bbl21/STM32_ctrlmodule/docs/项目概况.md

# 射频前端控制模块 — 项目概况

## 1. 项目简介

本系统是 **8~18GHz 射频前端** 的配套控制模块，用于天线选择、极化切换、信号路由、IF 衰减调节和参考通道选择。整个系统由 **STM32F103 控制板（硬件 + 固件）** 和 **Qt6 PC 控制软件（上位机）** 组成，通过 USB CDC（虚拟串口）通信。

### 核心功能

| 功能 | 说明 |
|---|---|
| 天线选择 | 8 路天线 (A-H) 独立选通，每路 V/H 极化可切换 |
| 直通模式 | 天线 B/C/F/G 可选直通（跳过变频级） |
| 下变频控制 | 三组 25中频模块，每通道窄/宽带选择 + 0-15dB 衰减 |
| 参考通道 | 外部 4 路参考信号经 SP4T 4选1 注入第三中频模块 |
| 本振驱动 | 模块 D 为三个 25中频模块提供本振信号 |

---

## 2. 系统架构

### 总体框图

```
                 USB CDC (12字节 = 96位)
PC 控制软件 ───────────────────────────→ STM32F103 固件
(Qt6/C++)      ┌──────────────────┐         │
               │  ControlWord     │         │ reverse_nibble
               │  模板管理         │         │ + 字节重排
               │  手动输入        │         │
               └──────────────────┘         ▼
                                         74HC595 链 (串转并, 96位)
                                             │
                                      ┌──────┴──────┐
                                      │  3× D-sub   │
                                      │  37芯 (5GND  │
                                      │  +32数据/个)  │
                                      └──────┬──────┘
                                             │
                ┌────────────────────────────┼────────────────────┐
                ▼                            ▼                    ▼
        15芯接收变频模块1         15芯接收变频模块2          25中频模块×3
        (天线 A,B,C,D)           (天线 E,F,G,H)          (8天线+1参考)
         K1=A, K2=B,              K1=E, K2=F,           每模块: IF1/IF2/IF3
         K3=C, K4=D               K3=G, K4=H            窄/宽带 + 0-15dB衰减
          B,C有直通(K2ZT/K3ZT)     F,G有直通(K2ZT/K3ZT)
```

### 信号流程

```
══════ RF 射频信号    ─ ─ ─ 本振信号    ······ 参考信号

天线 A (RF) ──┐
天线 B (RF) ──┤  ╔════════════╗
天线 C (RF) ──┤──║ 15芯接收变频 ║── RF ──┐
天线 D (RF) ──┤  ║   模块 1    ║        │
               ╚════════════╝        │
                                        │  ╔════════════╗
天线 E (RF) ──┐  ╔════════════╗       ├──║ C1 25中频   ║── IF1/IF2/IF3
天线 F (RF) ──┤──║ 15芯接收变频 ║── RF ┤  ║ (下变频)    ║    │
天线 G (RF) ──┤  ║   模块 2    ║       │  ╚════════════╝    │
天线 H (RF) ──┘  ╚════════════╝       │  ╔════════════╗    │
                                         │  ║ C2 25中频   ║── │── IF输出
                                         └──║ (下变频)    ║    │   (至后端)
                                            ╚════════════╝    │
                                            ╔════════════╗    │
参考信号 ──── 21芯参考频模II ······ SP4T ──╢ C3 25中频   ║───┘
(外部注入)      (模块B)       4选1         ║ IF1/IF2=天线 ║
                                            ║ IF3=参考通道 ║
                                            ╚════════════╝
                                                ▲     ▲
                                                │     │
                                         ╔══════╧═════╧══╗
                                         ║  模块 D       ║
                                         ║ 功放/本振     ║
                                         ║ (为C提供LO)   ║
                                         ╚═══════════════╝
```

| 步骤 | 路径 | 说明 |
|---|---|---|
| ① 天线接收 | 8 路天线 (A-H) → 15芯接收变频模块 1/2 | 每路 RF 经极化选择 (V/H) 后输出，B/C 和 F/G 可选直通 |
| ② 下变频 | RF → 25中频模块 C1/C2/C3 | 在模块 D 提供的本振信号下，RF 下变频为 IF，同时完成窄/宽带选择和 0-15dB 衰减 |
| ③ 通道分配 | C1→天线 A/B, C2→天线 C/D, C3→天线 E/F + 参考 | 共 9 路 IF 通道（8 天线 + 1 参考），C3 的 IF3 为参考通道输出 |
| ④ 参考注入 | 外部参考信号 → 21芯参考频模II (SP4T 4选1) → C3 IF3 | 模块 B 选择 4 路参考之一，送入 C3 的第 3 路 IF |
| ⑤ 本振供给 | 模块 D → C1/C2/C3 | 模块 D 为三个 25中频模块提供本振信号驱动下变频 |

---

## 3. 硬件设计

### 控制板 (STM32F103)

主控芯片 **STM32F103C8T6**，通过 SPI 驱动 12 片 74HC595 移位寄存器链，产生 96 位并行控制信号，经三路 D-sub 37 芯连接器输出至各射频模块。

#### 引脚分配

| 引脚 | 功能 | 连接 |
|---|---|---|
| PA5 | SPI1 SCK | 74HC595 SHCP (移位时钟) |
| PA7 | SPI1 MOSI | 74HC595 DS (串行数据) |
| PB3 | 输出使能 | 74HC595 OE (低有效) |
| PB5 | 锁存信号 | 74HC595 STCP (上升沿锁存) |
| PA11/USB_DM | USB 差分负 | USB CDC |
| PA12/USB_DP | USB 差分正 | USB CDC |

#### 74HC595 链结构

- 12 片 74HC595 级联，每片 8 位 → 96 位并行输出
- 每路 D-sub 37 芯连接器分配 32 位数据 + 5 位 GND
- 上电默认 OE 为高（输出高阻），初始化后拉低使能

### 子模块清单

| 模块 | 数量 | 接插件 | 控制信号 |
|---|---|---|---|
| 15芯接收变频模块 | 2 | 15芯 J30J | K1A/B-K4A/B (V/H), K2ZT, K3ZT |
| 21芯参考频模II | 1 | 21芯 J30J | KCKA, KCKB (SP4T) |
| 25中频模块 | 3 | 25芯 J30J | 窄/宽带 + 1/2/3ATT1/2/4/8 |
| 9芯功放模块 | 1 | 9芯 J30J | 仅供电 |

#### 天线分配

| 模块 | 天线 | 直通 |
|---|---|---|
| 15芯模块1 | A (K1), B (K2), C (K3), D (K4) | B, C |
| 15芯模块2 | E (K1), F (K2), G (K3), H (K4) | F, G |

---

## 4. 固件设计 (STM32F103)

### 目录: `firmware/`

| 文件 | 功能 |
|---|---|
| `Core/Src/main.c` | 主循环：轮询 `data_received`，执行 96 位全位序反转，SPI 发送，PB5 锁存 |
| `USB_DEVICE/App/usbd_cdc_if.c` | CDC 接收回调 `CDC_Receive_FS()`，接收 12 字节后置标志 |
| `Core/Src/stm32f1xx_hal_msp.c` | SPI1 引脚初始化 (PA5=SCK, PA7=MOSI) |
| `Core/Src/stm32f1xx_it.c` | USB 中断处理 |

### 核心算法

从 USB CDC 接收 12 字节后，固件执行 96 位全位序反转，将 PC 端定义的位位置映射到 74HC595 链的并行输出顺序：

```c
// 12字节(96位) → 96位全位序反转 → 6×16位 SPI (MSB first)
for (int i = 0; i < 12; i++) {
    for (int b = 0; b < 8; b++) {
        if (received_data[i] & (0x80 >> b)) {
            int pos = 95 - (i * 8 + b);
            spi_buffer[pos / 16] |= (0x8000 >> (pos % 16));
        }
    }
}
// SPI 发送 6×16 位，PB5 脉冲锁存
```

**特性：PC 输入的第 n 位 = 595 输出的第 n 位**，全位序反转补偿了 SPI MSB-first 传输与 595 级联间的位序差异。

### 工作流程

```
上电 → 初始化(HAL/SPI/USB) → PB3=0 使能输出 → 主循环:
  ┌─ CDC 收到 12 字节?
  ├─ 是 → 回显 Received: + 12字节hex
  │     → 96位全位序反转 → SPI 发送 → PB5 脉冲锁存
  │     → 回显 SPI Send: + 6×16位hex
  │     → 回显 Operation completed
  └─ 否 → 继续轮询
```

> **调试回显**：固件通过 CDC 回传接收/发送数据用于调试，PC 端可在日志窗口查看。

---

## 5. PC 控制软件 (Qt6/C++)

### 目录: `software/pc_control/`

| 文件 | 功能 |
|---|---|
| `main.cpp` | Qt 应用入口 |
| `mainwindow.h/cpp` | 主窗口、布局、工具栏、手动输入 |
| `controlword.h/cpp` | 96 位控制字构建核心类 |
| `cdccomm.h/cpp` | CDC 串口通信 |
| `templatemanager.h/cpp` | 模板 JSON 保存/加载 |
| `themedata.h/cpp` | 明暗双主题引擎 + QSS 生成器 |
| `antennastatuspanel.h/cpp` | 九宫格天线面板（V/名/H/直通） |
| `attenuatorpanel.h/cpp` | 9通道 IF 衰减 + 宽窄带 + 参考通道 |
| `statspanel.h/cpp` | 状态监视（Hex/二进制/日志） |
| `app.rc` / `app.ico` | 应用图标资源 |

### 构建

```bash
cd software/pc_control
cmake -B build -DCMAKE_PREFIX_PATH=/path/to/Qt6-static
cmake --build build --config Release
```

产物: `build/rf_frontend_control.exe` — **静态链接 Qt 6.8.3**（13.5 MB，零外部 DLL 依赖）

### 编译

运行: `build/rf_frontend_control.exe` (单 exe，无 DLL 依赖)

### 软件特性

- **明暗双主题**：暗色 (`#0a0a0a`) / 亮色 (`#f2f2f2`)，工具栏一键切换，主题偏好持久化
- **九宫格天线面板**：每天线独立 V/H 极化、直通开关，状态实时回显
- **模板管理**：将当前全状态保存为模板（JSON，含脏掩码），支持应用/修改/删除/双击应用；内置 STANDBY 模板
- **手动输入**：直接填写 12 字节十六进制控制字
- **衰减控制**：9 路独立 0-15dB 滑条 + 窄/宽带联动
- **参考通道**：SP4T 四选一控制字生成
- **实时通信日志**：发送/接收数据帧记录
- **数据目录**：`%APPDATA%/rf_frontend_control/`

---

## 6. 通信协议

### USB CDC (虚拟串口)

| 参数 | 值 |
|---|---|
| 接口 | USB 2.0 Full-Speed (12 Mbps) |
| CDC 类 | 抽象控制模型 (ACM) |
| 数据帧 | 12 字节固定帧，96 位控制字 |
| 方向 | 双向：PC→固件（控制字下发），固件→PC（调试回显） |
| 回显协议 | 固件收到 12 字节后，依次回传 "Received: XX..."、"SPI Send: XXXX..."、"Operation completed" |
| 波特率 | 虚拟串口忽略，USB 原生速率 |

### 数据帧

```
位 0-95: 96 位控制字
字节 0-11: 大端序，每字节低位在先 (因 nibble swap 补偿)
```

### 固件处理

```
USB 12 字节 → 96位全位序反转 → 6 × 16 位 SPI → 595 锁存
```

---

## 7. 96 位控制字映射

### 硬件数据路径

```
PC CDC (12字节=96位) → STM32F103 SPI1 (6×16位, MSB first)
  → 74HC595 移位寄存器链 (串转并, 96位并行输出)
  → 3× D-sub 37芯接插件 (每个: 5×GND + 32×数据线)
  → 子模块 J30J 接插件
```

### D-sub 37 芯接插件

每个 D-sub 37 芯：引脚 1-5 = GND，引脚 6-37 = 32 位数据线。

### 位映射详表

#### D-sub 1 (位 0-31) — 15芯接收变频模块 ×2 + 参考通道

| 位 | D-sub 引脚 | 信号 | 归属 | 说明 |
|----|---|---|---|---|
| **15芯接收变频模块 1 (天线 A,B,C,D) — 天线2(B)天线3(C)有直通** |
| 0 | pin6  | K3B | 天线 C V | 1=通 |
| 1 | pin7  | K3A | 天线 C H | 1=通 |
| 2 | pin8  | K4B | 天线 D V | 1=通 |
| 3 | pin9  | K4A | 天线 D H | 1=通 |
| 4 | pin10 | K1A | 天线 A V | 1=通 |
| 5 | pin11 | K1B | 天线 A H | 1=通 |
| 6 | pin12 | K2A | 天线 B V | 1=通 |
| 7 | pin13 | K2B | 天线 B H | 1=通 |
| 8 | pin14 | K2ZT | 天线 B 直通 | 1=直通 0=截止 |
| 9 | pin15 | K3ZT | 天线 C 直通 | 1=直通 0=截止 |
| **15芯接收变频模块 2 (天线 E,F,G,H) — 天线2(F)天线3(G)有直通** |
| 10 | pin16 | K3B | 天线 G V | 1=通 |
| 11 | pin17 | K3A | 天线 G H | 1=通 |
| 12 | pin18 | K4B | 天线 H V | 1=通 |
| 13 | pin19 | K4A | 天线 H H | 1=通 |
| 14 | pin20 | K1A | 天线 E V | 1=通 |
| 15 | pin21 | K1B | 天线 E H | 1=通 |
| 16 | pin22 | K2A | 天线 F V | 1=通 |
| 17 | pin23 | K2B | 天线 F H | 1=通 |
| 18 | pin24 | K2ZT | 天线 F 直通 | 1=直通 0=截止 |
| 19 | pin25 | K3ZT | 天线 G 直通 | 1=直通 0=截止 |
| **参考通道 SP4T** |
| 20 | pin26 | KCKA | 参考通道选择 A | 见编码表 |
| 21 | pin27 | KCKB | 参考通道选择 B | 见编码表 |
| **备用** |
| 22-31 | pin28-37 | — | — | 保留 |

#### D-sub 2 (位 32-63) — 25中频模块 C1 + C2

C1 占 18 位连续，C2 占 14 位，C2 的 IF3 衰减（位 64-67）在 D-sub3 开头。

| 位 | D-sub 引脚 | 信号 | 归属 | 说明 |
|----|---|---|---|---|
| **C1: 25中频模块 1 (位32-49, 18位)** |
| 32 | pin6  | KIF11 | IF1 窄带入 | 联动对 |
| 33 | pin7  | KIF12 | IF1 窄带出 | 联动对 |
| 34 | pin8  | KIF21 | IF2 窄带入 | 联动对 |
| 35 | pin9  | KIF22 | IF2 窄带出 | 联动对 |
| 36 | pin10 | KIF31 | IF3 窄带入 | 联动对 |
| 37 | pin11 | KIF32 | IF3 窄带出 | 联动对 |
| 38 | pin12 | 1ATT1 | IF1 衰减1dB | ⬅ |
| 39 | pin13 | 1ATT2 | IF1 衰减2dB | |
| 40 | pin14 | 1ATT4 | IF1 衰减4dB | |
| 41 | pin15 | 1ATT8 | IF1 衰减8dB | ➡ |
| 42 | pin16 | 2ATT1 | IF2 衰减1dB | ⬅ |
| 43 | pin17 | 2ATT2 | IF2 衰减2dB | |
| 44 | pin18 | 2ATT4 | IF2 衰减4dB | |
| 45 | pin19 | 2ATT8 | IF2 衰减8dB | ➡ |
| 46 | pin20 | 3ATT1 | IF3 衰减1dB | ⬅ |
| 47 | pin21 | 3ATT2 | IF3 衰减2dB | |
| 48 | pin22 | 3ATT4 | IF3 衰减4dB | |
| 49 | pin23 | 3ATT8 | IF3 衰减8dB | ➡ |
| **C2: 25中频模块 2 (位50-63, 14位；IF3衰减→D-sub3位64-67)** |
| 50 | pin24 | KIF11 | IF1 窄带入 | 联动对 |
| 51 | pin25 | KIF12 | IF1 窄带出 | 联动对 |
| 52 | pin26 | KIF21 | IF2 窄带入 | 联动对 |
| 53 | pin27 | KIF22 | IF2 窄带出 | 联动对 |
| 54 | pin28 | KIF31 | IF3 窄带入 | 联动对 |
| 55 | pin29 | KIF32 | IF3 窄带出 | 联动对 |
| 56 | pin30 | 1ATT1 | IF1 衰减1dB | ⬅ |
| 57 | pin31 | 1ATT2 | IF1 衰减2dB | |
| 58 | pin32 | 1ATT4 | IF1 衰减4dB | |
| 59 | pin33 | 1ATT8 | IF1 衰减8dB | ➡ |
| 60 | pin34 | 2ATT1 | IF2 衰减1dB | ⬅ |
| 61 | pin35 | 2ATT2 | IF2 衰减2dB | |
| 62 | pin36 | 2ATT4 | IF2 衰减4dB | |
| 63 | pin37 | 2ATT8 | IF2 衰减8dB | ➡ |

#### D-sub 3 (位 64-95) — C2 续 + C3 + 备用

| 位 | D-sub 引脚 | 信号 | 归属 | 说明 |
|----|---|---|---|---|
| **C2 续 (位64-67, 接D-sub2位50-63后)** |
| 64 | pin6  | 3ATT1 | C2 IF3 衰减1dB | ⬅ |
| 65 | pin7  | 3ATT2 | C2 IF3 衰减2dB | |
| 66 | pin8  | 3ATT4 | C2 IF3 衰减4dB | |
| 67 | pin9  | 3ATT8 | C2 IF3 衰减8dB | ➡ |
| **C3: 25中频模块 3 (位68-85, 18位)** |
| 68 | pin10 | KIF11 | IF1 窄带入 | 联动对 |
| 69 | pin11 | KIF12 | IF1 窄带出 | 联动对 |
| 70 | pin12 | KIF21 | IF2 窄带入 | 联动对 |
| 71 | pin13 | KIF22 | IF2 窄带出 | 联动对 |
| 72 | pin14 | KIF31 | IF3 窄带入 | 联动对 |
| 73 | pin15 | KIF32 | IF3 窄带出 | 联动对 |
| 74 | pin16 | 1ATT1 | IF1 衰减1dB | ⬅ |
| 75 | pin17 | 1ATT2 | IF1 衰减2dB | |
| 76 | pin18 | 1ATT4 | IF1 衰减4dB | |
| 77 | pin19 | 1ATT8 | IF1 衰减8dB | ➡ |
| 78 | pin20 | 2ATT1 | IF2 衰减1dB | ⬅ |
| 79 | pin21 | 2ATT2 | IF2 衰减2dB | |
| 80 | pin22 | 2ATT4 | IF2 衰减4dB | |
| 81 | pin23 | 2ATT8 | IF2 衰减8dB | ➡ |
| 82 | pin24 | 3ATT1 | IF3 衰减1dB | ⬅ |
| 83 | pin25 | 3ATT2 | IF3 衰减2dB | |
| 84 | pin26 | 3ATT4 | IF3 衰减4dB | |
| 85 | pin27 | 3ATT8 | IF3 衰减8dB | ➡ |
| **备用** |
| 86-95 | pin28-37 | — | — | 保留 |

### 参考通道编码 (KCKA, KCKB)

| KCKA | KCKB | 参考通道 |
|---|---|---|
| 1 | 1 | 通道 1 |
| 1 | 0 | 通道 2 |
| 0 | 1 | 通道 3 |
| 0 | 0 | 通道 4 |

### IF 宽窄带联动

KIFx1 (入) 和 KIFx2 (出) 应联动控制：

| KIFx1 (入) | KIFx2 (出) | 模式 |
|---|---|---|
| 0 (窄带)  | 1 (窄带) | 窄带 |
| 1 (宽带)  | 0 (宽带) | 宽带 |

### IF 衰减组合

| ATT1 | ATT2 | ATT4 | ATT8 | 总衰减 |
|---|---|---|---|---|
| 0 | 0 | 0 | 0 | 0dB |
| 1 | 0 | 0 | 0 | 1dB |
| 0 | 1 | 0 | 0 | 2dB |
| 1 | 1 | 0 | 0 | 3dB |
| 0 | 0 | 1 | 0 | 4dB |
| 0 | 0 | 0 | 1 | 8dB |
| 1 | 1 | 1 | 1 | 15dB |

---

## 8. 硬件接口与连线

### 控制板 → 射频模块

```
控制板 (STM32F103)
  │
  ├── D-sub 1 (37芯) ──── 15芯接收变频模块1 (天线 A-D)
  │                          ├── K1A/B: 天线 A V/H
  │                          ├── K2A/B: 天线 B V/H
  │                          ├── K2ZT:  天线 B 直通
  │                          ├── K3A/B: 天线 C V/H
  │                          ├── K3ZT:  天线 C 直通
  │                          └── K4A/B: 天线 D V/H
  │
  ├── D-sub 2 (37芯) ──── 15芯接收变频模块2 (天线 E-H)
  │                      + 25中频模块1 (C1) + 25中频模块2 (C2)
  │
  └── D-sub 3 (37芯) ──── 25中频模块3 (C3) + 参考通道
```

### USB 连接

```
PC ── USB A ── USB 线 ── USB Mini-B ── 控制板 (STM32F103)
```

## 8. 硬件接口与连线

### 控制板 → 射频模块

```
控制板 (STM32F103)
  │
  ├── D-sub 1 (37芯) ──── 15芯接收变频模块1 (天线 A-D)
  │                          ├── K1A/B: 天线 A V/H
  │                          ├── K2A/B: 天线 B V/H
  │                          ├── K2ZT:  天线 B 直通
  │                          ├── K3A/B: 天线 C V/H
  │                          ├── K3ZT:  天线 C 直通
  │                          └── K4A/B: 天线 D V/H
  │
  ├── D-sub 2 (37芯) ──── 15芯接收变频模块2 (天线 E-H)
  │                      + 25中频模块1 (C1) + 25中频模块2 (C2)
  │
  └── D-sub 3 (37芯) ──── 25中频模块3 (C3) + 参考通道
```

### USB 连接

```
PC ── USB A ── USB 线 ── USB Mini-B ── 控制板 (STM32F103)
```

---

## 9. 文件索引

```
STM32_ctrlmodule/
├── firmware/                     (STM32F103 固件)
│   ├── Core/Src/main.c           主循环 + SPI + 位序反转
│   ├── Core/Src/stm32f1xx_hal_msp.c  SPI 引脚初始化 (PA5=SCK, PA7=MOSI)
│   ├── Core/Src/stm32f1xx_it.c    USB 中断
│   ├── USB_DEVICE/App/usbd_cdc_if.c  CDC 接收 + 调试回显
│   └── ctrl_module_v4.ioc         CubeMX 配置
│
├── software/                     (PC 上位机)
│   └── pc_control/                Qt6 C++ 控制软件
│       ├── src/                   源码
│       └── CMakeLists.txt         构建配置
│
├── hardware/                     (电路设计)
│   ├── lceda/                     立创EDA 工程文件
│   ├── bom/                       BOM 物料清单
│   └── pnp/                       Pick & Place
│
├── enclosure/                    (外壳 3D 模型)
│   ├── 上盖.STEP.SLDPRT
│   └── 底盒.STEP.SLDPRT
│
├── docs/                         (项目文档)
│   ├── 项目概况.md                 本文档
│   ├── 96位数据位映射定义.md         位映射详表
│   └── ...                        其他资料
│
└── .gitignore
```

---

## 10. 开发环境

| 组件 | 版本 | 位置 |
|---|---|---|
| MCU | STM32F103C8T6, STM32CubeIDE | — |
| PC 编译 | MSVC 14.44 + CMake 3.31 | VS2022 BuildTools |
| Qt (动态) | 6.8.3 msvc2022_64 | `~/Qt/6.8.3/msvc2022_64` |
| Qt (静态, 单 exe) | 6.8.3 自编译 -static | `~/Qt/6.8.3-static/msvc2022_64` |
| PCB 设计 | 立创EDA | — |
| 3D 建模 | SolidWorks 2022 | — |
