bbl21/STM32_ctrlmodule/firmware/docs/96位数据位映射定义.md

# 96 位数据位映射定义

## 硬件架构

```
PC CDC (12字节=96位)
  → STM32F103 SPI1 (6×16位, MSB first)
  → 74HC595 移位寄存器链 (串转并, 96位并行输出)
  → 3× D-sub 37芯接插件 (每个: 5×GND + 32×数据线)
  → 子模块 J30J 接插件
```

### D-sub 37 芯接插件引脚定义

每个 D-sub 37 芯：
| 引脚范围 | 功能 |
|---|---|
| 1-5 | GND (共地) |
| 6-37 | 32 位数据线 |

---

## CDC → SPI 映射算法 (核心)

### 黑箱行为

**PC 输入 96 位 → MCU 处理后 → 595 输出 96 位 = 一一对应。**

具体地说，PC 发过来的 96 位数据中第 N 位（从 0 开始计数），经过 MCU 处理后，最终落到物理连线上第 N 个输出位（D-sub 各接插件引脚6-37 顺序排列）。

关键在于算法补偿了 CDC 字节序和 SPI 硬件时序之间的差异，使 PC 视角无需关心底层细节。

### 逐级映射详解

#### 第 1 层：PC 字节 → received_data[]

PC 发送 12 个字节（96 位），按 USB CDC 流顺序存入 `received_data[0..11]`。

```
PC 发送字节顺序:  byte0  byte1  byte2  ...  byte11
                         ↓
MCU 接收数组:  received_data[0..11]
```

#### 第 2 层：received_data[] → nibble 交换 + 组内逆序

每 4 字节为一组（共 3 组），组内执行：

```
原始字节: [b0] [b1] [b2] [b3]
                ↓  reverse_nibble()
nibble 交换: [rn(b0)] [rn(b1)] [rn(b2)] [rn(b3)]
                ↓  组内逆序组合
SPI 字:  spi_buffer[2i]   = rn(b3):rn(b2)   (高16位)
          spi_buffer[2i+1] = rn(b1):rn(b0)   (低16位)
```

`reverse_nibble()` 函数：

```c
// 输入:  0x1K  (高4位=1, 低4位=K)
// 输出:  0xK1  (高4位=K, 低4位=1)
static uint8_t reverse_nibble(uint8_t byte) {
    return ((byte & 0x0F) << 4) | ((byte & 0xF0) >> 4);
}
```

#### 第 3 层：spi_buffer[] → SPI 发送 (MSB first)

依次发送 6 个 16 位字，每个字 MSB first（先发高位，后发低位）。

```
SPI 线上 bit 流顺序:
buf[0].b15 → ... → buf[0].b0 → buf[1].b15 → ... → buf[1].b0
→ buf[2].b15 → ... → buf[5].b15 → ... → buf[5].b0
```

#### 第 4 层：SPI 位流 → 595 链 → 并行输出

74HC595 是串入并出移位寄存器，链式级联。**最先移入的 bit 到达链尾（最远一级 595），最后移入的 bit 停在链头（最近一级 595）。**

```
SPI 位流顺序 (时间先后)
  先发送 ───── buf[0].b15 → ... → buf[5].b0 ───── 后发送
               ↓                          ↓
          最远一级 595  ← ... ←  最近一级 595
          (D-sub3.pin37)          (D-sub1.pin6)

物理输出对应:
  D-sub1.pin6   ← LSB(buf[5])  ← 最近 595 的第 0 位
  D-sub1.pin7   ← bit1(buf[5]) ← 最近 595 的第 1 位
  ...
  D-sub3.pin37  ← MSB(buf[0])  ← 最远 595 的第 15 位
```

### 验证：PC 输入 "1000" → 输出 "0001"

以 4 位为例演示 nibble 补偿：

```
PC 发送 1 字节:  0x80  (二进制 1000 0000)
      高4位=1000, 低4位=0000

reverse_nibble(0x80):
  高4位 ← 原低4位 = 0000
  低4位 ← 原高4位 = 1000
  → 0x08  (二进制 0000 1000)

nibble "1000" 从高4位 → 低4位 = 0001 ← 输出映射
```

物理结果：PC 送的高 nibble "1000" 经由 nibble 交换后变为低 nibble，落在 D-sub 对应引脚上。从 PC 视角看，"1000" 输入对应的是同一个物理引脚上的 "1"，完成了 1:1 映射。

### 完整对应表

**96 位数据 → D-sub 引脚对照（按物理输出位置，从近到远）：**

| 输出位序 | 数据位标号 | D-sub 引脚 | 来源 |
|---|---|---|---|
| 0 | bit[0] | D-sub1.pin6  | `received_data[8]` nibble 交换后的 bit0 |
| 1 | bit[1] | D-sub1.pin7  | `received_data[8]` nibble 交换后的 bit1 |
| ... | ... | ... | ... |
| 31 | bit[31] | D-sub1.pin37 | `received_data[11]` nibble 交换后的 bit7 |
| 32 | bit[32] | D-sub2.pin6  | `received_data[4]` nibble 交换后的 bit0 |
| ... | ... | ... | ... |
| 63 | bit[63] | D-sub2.pin37 | `received_data[7]` nibble 交换后的 bit7 |
| 64 | bit[64] | D-sub3.pin6  | `received_data[0]` nibble 交换后的 bit0 |
| ... | ... | ... | ... |
| 95 | bit[95] | D-sub3.pin37 | `received_data[3]` nibble 交换后的 bit7 |

> 注：transmit 后拉高 PB5 (STCP) 产生上升沿锁存，将移位寄存器内容并行输出到 595 输出引脚。

---

## D-sub 1 (位 0-31) → 子模块映射

**对应 SPI 字:** `spi_buffer[0..1]`

### 连接子模块

1. **参考频模** (15 芯 J30J) — 10 路 LVTTL
2. **参考频模 II** (21 芯 J30J) — 2 路 LVTTL (KCKA, KCKB)
3. 备用/未分配位

### 位分配表

| 位编号 | D-sub 引脚 | 子模块 | J30J 信号 | 说明 | 逻辑 |
|---|---|---|---|---|---|
| **参考频模 (10 位)** |
| 0  | D-sub1.pin6  | 参考频模 | K3B | 开关 3B 控制 | 1=通, 0=断 |
| 1  | D-sub1.pin7  | 参考频模 | K3A | 开关 3A 控制 | 1=通, 0=断 |
| 2  | D-sub1.pin8  | 参考频模 | K4B | 开关 4B 控制 | 1=通, 0=断 |
| 3  | D-sub1.pin9  | 参考频模 | K4A | 开关 4A 控制 | 1=通, 0=断 |
| 4  | D-sub1.pin10 | 参考频模 | K1A | 开关 1A 控制 | 1=通, 0=断 |
| 5  | D-sub1.pin11 | 参考频模 | K1B | 开关 1B 控制 | 1=通, 0=断 |
| 6  | D-sub1.pin12 | 参考频模 | K2A | 开关 2A 控制 | 1=通, 0=断 |
| 7  | D-sub1.pin13 | 参考频模 | K2B | 开关 2B 控制 | 1=通, 0=断 |
| 8  | D-sub1.pin14 | 参考频模 | K2ZT  | 通道 2 直通选择 | 1=直通, 0=截止 |
| 9  | D-sub1.pin15 | 参考频模 | K3ZT  | 通道 3 直通选择 | 1=直通, 0=截止 |
| **参考频模 II (2 位)** |
| 10 | D-sub1.pin16 | 参考频模II | KCKA  | 参考通道选择 A | 见表 |
| 11 | D-sub1.pin17 | 参考频模II | KCKB  | 参考通道选择 B | 见表 |
| **备用地线 (5 路)** |
| —  | D-sub1.pin1-5 | 参考频模 | GND×5 | 模块共地 (每个 D-sub 固定 5 针) |
| **备用位 (20 位)** |
| 12-31 | D-sub1.pin18-37 | — | — | 保留/未分配 | — |

### KCKA, KCKB 编码表

| KCKA | KCKB | 参考通道 |
|---|---|---|
| 1 | 1 | 通道 1 |
| 1 | 0 | 通道 2 |
| 0 | 1 | 通道 3 |
| 0 | 0 | 通道 4 |

---

## D-sub 2 (位 32-63) → 子模块映射

**对应 SPI 字:** `spi_buffer[2..3]`

### 连接子模块

1. **第一路 25 频模** (25 芯 J30J) — IF1/IF2/IF3 控制 (18 路 LVTTL)
2. 备用 14 位

### 位分配表

| 位编号 | D-sub 引脚 | 子模块 | J30J 信号 | 说明 | 逻辑 |
|---|---|---|---|---|---|
| **IF 窄带/宽带选择 (6 位)** |
| 32 | D-sub2.pin6  | 25频模-IF1 | KIF11 | IF1 窄带开关(入) | 0=窄带, 1=宽带 |
| 33 | D-sub2.pin7  | 25频模-IF2 | KIF21 | IF2 窄带开关(入) | 0=窄带, 1=宽带 |
| 34 | D-sub2.pin8  | 25频模-IF3 | KIF31 | IF3 窄带开关(入) | 0=窄带, 1=宽带 |
| 35 | D-sub2.pin9  | 25频模-IF3 | KIF32 | IF3 窄带开关(出) | 1=窄带, 0=宽带 |
| 36 | D-sub2.pin10 | 25频模-IF2 | KIF22 | IF2 窄带开关(出) | 1=窄带, 0=宽带 |
| 37 | D-sub2.pin11 | 25频模-IF1 | KIF12 | IF1 窄带开关(出) | 1=窄带, 0=宽带 |
| **IF3 衰减器 (4 位)** |
| 38 | D-sub2.pin12 | 25频模-IF3 | 3ATT1 | IF3 衰减 1dB | 1=衰减 |
| 39 | D-sub2.pin13 | 25频模-IF3 | 3ATT2 | IF3 衰减 2dB | 1=衰减 |
| 40 | D-sub2.pin14 | 25频模-IF3 | 3ATT4 | IF3 衰减 4dB | 1=衰减 |
| 41 | D-sub2.pin15 | 25频模-IF3 | 3ATT8 | IF3 衰减 8dB | 1=衰减 |
| **IF2 衰减器 (4 位)** |
| 42 | D-sub2.pin16 | 25频模-IF2 | 2ATT1 | IF2 衰减 1dB | 1=衰减 |
| 43 | D-sub2.pin17 | 25频模-IF2 | 2ATT2 | IF2 衰减 2dB | 1=衰减 |
| 44 | D-sub2.pin18 | 25频模-IF2 | 2ATT4 | IF2 衰减 4dB | 1=衰减 |
| 45 | D-sub2.pin19 | 25频模-IF2 | 2ATT8 | IF2 衰减 8dB | 1=衰减 |
| **IF1 衰减器 (4 位)** |
| 46 | D-sub2.pin20 | 25频模-IF1 | 1ATT1 | IF1 衰减 1dB | 1=衰减 |
| 47 | D-sub2.pin21 | 25频模-IF1 | 1ATT2 | IF1 衰减 2dB | 1=衰减 |
| 48 | D-sub2.pin22 | 25频模-IF1 | 1ATT4 | IF1 衰减 4dB | 1=衰减 |
| 49 | D-sub2.pin23 | 25频模-IF1 | 1ATT8 | IF1 衰减 8dB | 1=衰减 |
| **备用地线 (5 路)** |
| —  | D-sub2.pin1-5 | 25频模 | GND×5 | 模块共地 | — |
| **备用位 (14 位)** |
| 50-63 | D-sub2.pin24-37 | — | — | 保留/未分配 | — |

### IF 衰减组合

| ATT1 | ATT2 | ATT4 | ATT8 | 总衰减 |
|---|---|---|---|---|
| 0 | 0 | 0 | 0 | 0dB |
| 1 | 0 | 0 | 0 | 1dB |
| 0 | 1 | 0 | 0 | 2dB |
| 1 | 1 | 0 | 0 | 3dB |
| 0 | 0 | 1 | 0 | 4dB |
| 0 | 0 | 0 | 1 | 8dB |
| 1 | 1 | 1 | 1 | 15dB (最大) |

---

## D-sub 3 (位 64-95) → 子模块映射

**对应 SPI 字:** `spi_buffer[4..5]`

### 连接子模块

1. **第二路 25 频模** (25 芯 J30J) — 第二路 IF1/IF2/IF3 控制 (18 路)
2. 或 **第三路 25 频模** (18 路)
3. **9 芯功放模块** (无控制信号，仅供电)
4. 备用位

### 位分配表 (方案: 第二路 25 频模)

| 位编号 | D-sub 引脚 | 子模块 | J30J 信号 | 说明 | 逻辑 |
|---|---|---|---|---|---|
| **IF 窄带/宽带选择 (6 位)** |
| 64 | D-sub3.pin6  | 25频模-路2-IF1 | KIF11 | IF1 窄带开关(入) | 0=窄带, 1=宽带 |
| 65 | D-sub3.pin7  | 25频模-路2-IF2 | KIF21 | IF2 窄带开关(入) | 0=窄带, 1=宽带 |
| 66 | D-sub3.pin8  | 25频模-路2-IF3 | KIF31 | IF3 窄带开关(入) | 0=窄带, 1=宽带 |
| 67 | D-sub3.pin9  | 25频模-路2-IF3 | KIF32 | IF3 窄带开关(出) | 1=窄带, 0=宽带 |
| 68 | D-sub3.pin10 | 25频模-路2-IF2 | KIF22 | IF2 窄带开关(出) | 1=窄带, 0=宽带 |
| 69 | D-sub3.pin11 | 25频模-路2-IF1 | KIF12 | IF1 窄带开关(出) | 1=窄带, 0=宽带 |
| **IF3 衰减器 (4 位)** |
| 70 | D-sub3.pin12 | 25频模-路2-IF3 | 3ATT1 | IF3 衰减 1dB | 1=衰减 |
| 71 | D-sub3.pin13 | 25频模-路2-IF3 | 3ATT2 | IF3 衰减 2dB | 1=衰减 |
| 72 | D-sub3.pin14 | 25频模-路2-IF3 | 3ATT4 | IF3 衰减 4dB | 1=衰减 |
| 73 | D-sub3.pin15 | 25频模-路2-IF3 | 3ATT8 | IF3 衰减 8dB | 1=衰减 |
| **IF2 衰减器 (4 位)** |
| 74 | D-sub3.pin16 | 25频模-路2-IF2 | 2ATT1 | IF2 衰减 1dB | 1=衰减 |
| 75 | D-sub3.pin17 | 25频模-路2-IF2 | 2ATT2 | IF2 衰减 2dB | 1=衰减 |
| 76 | D-sub3.pin18 | 25频模-路2-IF2 | 2ATT4 | IF2 衰减 4dB | 1=衰减 |
| 77 | D-sub3.pin19 | 25频模-路2-IF2 | 2ATT8 | IF2 衰减 8dB | 1=衰减 |
| **IF1 衰减器 (4 位)** |
| 78 | D-sub3.pin20 | 25频模-路2-IF1 | 1ATT1 | IF1 衰减 1dB | 1=衰减 |
| 79 | D-sub3.pin21 | 25频模-路2-IF1 | 1ATT2 | IF1 衰减 2dB | 1=衰减 |
| 80 | D-sub3.pin22 | 25频模-路2-IF1 | 1ATT4 | IF1 衰减 4dB | 1=衰减 |
| 81 | D-sub3.pin23 | 25频模-路2-IF1 | 1ATT8 | IF1 衰减 8dB | 1=衰减 |
| **备用地线 (5 路)** |
| —  | D-sub3.pin1-5 | 25频模路2 / 功放 | GND×5 | 模块共地 | — |
| **备用位 (14 位)** |
| 82-95 | D-sub3.pin24-37 | — | — | 保留/未分配 | — |

> 注：如果只有第一路 25 频模，则 D-sub 3 的 18 位 (位 64-81) 可作为备用或扩展给其他模块。

---

## 汇总：96 位地址空间总表

| 位范围 | 位计数 | D-sub | 子模块 | 功能 |
|---|---|---|---|---|
| 0-9 | 10 | 1 | 参考频模 | 开关 K1A-K4B, K2ZT, K3ZT |
| 10-11  | 2 | 1 | 参考频模II | 参考通道选择 KCKA, KCKB |
| 12-31  | 20 | 1 | — | 备用 (D-sub1 未用数据线) |
| 32-37  | 6 | 2 | 25频模-第一路 | IF1/2/3 窄带选择 |
| 38-41  | 4 | 2 | 25频模-IF3 | 3ATT1/2/4/8 衰减 |
| 42-45  | 4 | 2 | 25频模-IF2 | 2ATT1/2/4/8 衰减 |
| 46-49  | 4 | 2 | 25频模-IF1 | 1ATT1/2/4/8 衰减 |
| 50-63  | 14 | 2 | — | 备用 (D-sub2 未用数据线) |
| 64-69  | 6 | 3 | 25频模-第二路 | IF1/2/3 窄带选择 (若存在) |
| 70-73  | 4 | 3 | 25频模-第二路-IF3 | 3ATT1/2/4/8 (若存在) |
| 74-77  | 4 | 3 | 25频模-第二路-IF2 | 2ATT1/2/4/8 (若存在) |
| 78-81  | 4 | 3 | 25频模-第二路-IF1 | 1ATT1/2/4/8 (若存在) |
| 82-95  | 14 | 3 | — | 备用 (D-sub3 未用数据线) |

---

## GND 分配

每个 D-sub 37 芯接插件固定提供 5 根 GND 线（引脚 1-5）到子模块侧。

子模块 GND 需求：

| 子模块 | J30J 自带 GND | 需从 D-sub 获取 | 说明 |
|---|---|---|---|
| 参考频模 15芯 J30J | 引脚 5,6,13 (3路) | D-sub1 至少 1 路 | 其余走模块内部共地 |
| 参考频模II 21芯 J30J | 引脚 4-8,15,18 (7路) | D-sub1 至少 1 路 | 模块内 GND 充足 |
| 25频模 25芯 J30J | 引脚 4-9 (6路) | D-sub2/3 至少 1 路 | 每路 25 频模需独立 GND |
| 9芯功放 9芯 J30J | 引脚 4,5,8,9 (4路) | D-sub3 至少 1 路 | 纯供电模块 |

D-sub 接插件上所有 GND 引脚 (1-5) 在控制模块内部共地。

---

## STM32 代码对应关系

| 代码位置 | 内容 |
|---|---|
| `main.c:48` | `uint16_t spi_buffer[6]` — 6 个 16 位 SPI 数据 |
| `main.c:50-51` | `extern uint8_t received_data[12]`, `extern uint8_t data_received` |
| `main.c:61-68` | `reverse_byte()` — 全位反转 (旧版算法用) |
| `main.c:71-73` | `reverse_nibble()` — 高低四位交换 (当前算法) |
| `main.c:154-163` | 12 字节 → nibble swap → 重组 6×16 位 SPI 数据 |
| `main.c:175` | `HAL_SPI_Transmit()` — 发送 6 个 16 位数据到 595 链 |
| `main.c:176-178` | PB5 脉冲上升沿锁存并行输出 |
| `main.c:124-127` | PB3=低(使能595输出), PB5=低(STCP初始) |
| `usbd_cdc_if.c:262-277` | `CDC_Receive_FS()` — 接收 12 字节 USB CDC 数据 |
