bbl21/STM32_ctrlmodule/docs/96位数据位映射定义.md

# 96 位数据位映射定义

## 硬件架构

```
PC CDC (12字节=96位)
  → STM32F103 SPI1 (6×16位, MSB first)
  → 74HC595 移位寄存器链 (串转并, 96位并行输出)
  → 3× D-sub 37芯接插件 (每个: 5×GND + 32×数据线)
  → 子模块 J30J 接插件
```

### D-sub 37 芯接插件引脚定义

每个 D-sub 37 芯：
| 引脚范围 | 功能 |
|---|---|
| 1-5 | GND (共地) |
| 6-37 | 32 位数据线 |

---

## 总线模块清单

| 模块 | 数量 | 控制信号 | 说明 |
|---|---|---|---|
| 15芯接收变频模块 | 2个 | 10路/个 | 每个控制4个天线，KxA=V极 KxB=H极 |
| 25中频模块 | 3个 | 15路/个(+3备用) | 对应8天线+1参考通道 |
| 参考通道开关 | 1个 | 2路 | SP4T (KCKA, KCKB) 四选一 |

### 模块-天线对应

**15芯接收变频模块 1** — 天线 A, B, C, D
| J30J 信号 | 位置 | 控制对象 | 直通 |
|---|---|---|---|
| K1A/K1B | 天线1 | 天线 A V/H | 无 |
| K2A/K2B | 天线2 | 天线 B V/H | K2ZT |
| K3A/K3B | 天线3 | 天线 C V/H | K3ZT |
| K4A/K4B | 天线4 | 天线 D V/H | 无 |

**15芯接收变频模块 2** — 天线 E, F, G, H
| J30J 信号 | 位置 | 控制对象 | 直通 |
|---|---|---|---|
| K1A/K1B | 天线1 | 天线 E V/H | 无 |
| K2A/K2B | 天线2 | 天线 F V/H | K2ZT |
| K3A/K3B | 天线3 | 天线 G V/H | K3ZT |
| K4A/K4B | 天线4 | 天线 H V/H | 无 |

**25 中频模块 ×3** — 每模块对应一组 IF1/IF2/IF3 通道
| J30J 信号 | 数量 | 说明 |
|---|---|---|
| KIF1x (11/12) | 1路联动 | IF1 宽窄带选择，11入12出联动 |
| KIF2x (21/22) | 1路联动 | IF2 宽窄带选择 |
| KIF3x (31/32) | 1路联动 | IF3 宽窄带选择 |
| iATT1/2/4 (i=1,2,3) | 9路 | IF1/2/3 衰减器 0-7dB |
| iATT8 (备用) | 3路 | IF1/2/3 衰减器扩展 8dB |

**参考通道**
| SP4T 信号 | 编码 | 说明 |
|---|---|---|
| KCKA, KCKB | 11/10/01/00 | 参考通道 1/2/3/4 四选一 |

---

## 96 位地址分配

### D-sub 1 (位 0-31) — 15芯接收变频模块 ×2 + 参考通道

| 位 | D-sub 引脚 | 信号 | 归属 | 说明 |
|----|---|---|---|---|
| **15芯接收变频模块 1 (天线 A,B,C,D) — 天线2(B)天线3(C)有直通** |
| 0 | pin6  | K3B | 天线 C V | 1=通 |
| 1 | pin7  | K3A | 天线 C H | 1=通 |
| 2 | pin8  | K4B | 天线 D V | 1=通 |
| 3 | pin9  | K4A | 天线 D H | 1=通 |
| 4 | pin10 | K1A | 天线 A V | 1=通 |
| 5 | pin11 | K1B | 天线 A H | 1=通 |
| 6 | pin12 | K2A | 天线 B V | 1=通 |
| 7 | pin13 | K2B | 天线 B H | 1=通 |
| 8 | pin14 | K2ZT | 天线 B 直通 | 1=直通 0=截止 |
| 9 | pin15 | K3ZT | 天线 C 直通 | 1=直通 0=截止 |
| **15芯接收变频模块 2 (天线 E,F,G,H) — 天线2(F)天线3(G)有直通** |
| 10 | pin16 | K3B | 天线 G V | 1=通 |
| 11 | pin17 | K3A | 天线 G H | 1=通 |
| 12 | pin18 | K4B | 天线 H V | 1=通 |
| 13 | pin19 | K4A | 天线 H H | 1=通 |
| 14 | pin20 | K1A | 天线 E V | 1=通 |
| 15 | pin21 | K1B | 天线 E H | 1=通 |
| 16 | pin22 | K2A | 天线 F V | 1=通 |
| 17 | pin23 | K2B | 天线 F H | 1=通 |
| 18 | pin24 | K2ZT | 天线 F 直通 | 1=直通 0=截止 |
| 19 | pin25 | K3ZT | 天线 G 直通 | 1=直通 0=截止 |
| **参考通道 SP4T** |
| 20 | pin26 | KCKA | 参考通道选择 A | 见编码表 |
| 21 | pin27 | KCKB | 参考通道选择 B | 见编码表 |
| **备用** |
| 22-31 | pin28-37 | — | — | 保留 |

### D-sub 2 (位 32-63) — 25中频模块 C1 + C2（C2 续 D-sub3）

C1 占 18 位连续，C2 占 14 位，末 4 位（IF3 衰减）在 D-sub3 开头。

| 位 | D-sub 引脚 | 信号 | 归属 | 说明 |
|----|---|---|---|---|
| **C1: 25中频模块 1 (位32-49, 18位)** |
| 32 | pin6  | KIF11 | IF1 窄带入 | 联动对 |
| 33 | pin7  | KIF12 | IF1 窄带出 | 联动对 |
| 34 | pin8  | KIF21 | IF2 窄带入 | 联动对 |
| 35 | pin9  | KIF22 | IF2 窄带出 | 联动对 |
| 36 | pin10 | KIF31 | IF3 窄带入 | 联动对 |
| 37 | pin11 | KIF32 | IF3 窄带出 | 联动对 |
| 38 | pin12 | 1ATT1 | IF1 衰减1dB | ⬅ IF1 衰减连续4位 |
| 39 | pin13 | 1ATT2 | IF1 衰减2dB | |
| 40 | pin14 | 1ATT4 | IF1 衰减4dB | |
| 41 | pin15 | 1ATT8 | IF1 衰减8dB | ➡ |
| 42 | pin16 | 2ATT1 | IF2 衰减1dB | |
| 43 | pin17 | 2ATT2 | IF2 衰减2dB | |
| 44 | pin18 | 2ATT4 | IF2 衰减4dB | |
| 45 | pin19 | 2ATT8 | IF2 衰减8dB | |
| 46 | pin20 | 3ATT1 | IF3 衰减1dB | |
| 47 | pin21 | 3ATT2 | IF3 衰减2dB | |
| 48 | pin22 | 3ATT4 | IF3 衰减4dB | |
| 49 | pin23 | 3ATT8 | IF3 衰减8dB | |
| **C2: 25中频模块 2 (位50-63, 14位；IF3衰减→D-sub3位64-67)** |
| 50 | pin24 | KIF11 | IF1 窄带入 | 联动对 |
| 51 | pin25 | KIF12 | IF1 窄带出 | 联动对 |
| 52 | pin26 | KIF21 | IF2 窄带入 | 联动对 |
| 53 | pin27 | KIF22 | IF2 窄带出 | 联动对 |
| 54 | pin28 | KIF31 | IF3 窄带入 | 联动对 |
| 55 | pin29 | KIF32 | IF3 窄带出 | 联动对 |
| 56 | pin30 | 1ATT1 | IF1 衰减1dB | ⬅ IF1 衰减连续4位 |
| 57 | pin31 | 1ATT2 | IF1 衰减2dB | |
| 58 | pin32 | 1ATT4 | IF1 衰减4dB | |
| 59 | pin33 | 1ATT8 | IF1 衰减8dB | ➡ |
| 60 | pin34 | 2ATT1 | IF2 衰减1dB | |
| 61 | pin35 | 2ATT2 | IF2 衰减2dB | |
| 62 | pin36 | 2ATT4 | IF2 衰减4dB | |
| 63 | pin37 | 2ATT8 | IF2 衰减8dB | |

### D-sub 3 (位 64-95) — C2 续 + C3 + 备用

| 位 | D-sub 引脚 | 信号 | 归属 | 说明 |
|----|---|---|---|---|
| **C2 续 (位64-67, 接D-sub2位50-63后)** |
| 64 | pin6  | 3ATT1 | C2 IF3 衰减1dB | D-sub2位50-63的后续 |
| 65 | pin7  | 3ATT2 | C2 IF3 衰减2dB | |
| 66 | pin8  | 3ATT4 | C2 IF3 衰减4dB | |
| 67 | pin9  | 3ATT8 | C2 IF3 衰减8dB | |
| **C3: 25中频模块 3 (位68-85, 18位)** |
| 68 | pin10 | KIF11 | IF1 窄带入 | 联动对 |
| 69 | pin11 | KIF12 | IF1 窄带出 | 联动对 |
| 70 | pin12 | KIF21 | IF2 窄带入 | 联动对 |
| 71 | pin13 | KIF22 | IF2 窄带出 | 联动对 |
| 72 | pin14 | KIF31 | IF3 窄带入 | 联动对 |
| 73 | pin15 | KIF32 | IF3 窄带出 | 联动对 |
| 74 | pin16 | 1ATT1 | IF1 衰减1dB | ⬅ IF1 衰减连续4位 |
| 75 | pin17 | 1ATT2 | IF1 衰减2dB | |
| 76 | pin18 | 1ATT4 | IF1 衰减4dB | |
| 77 | pin19 | 1ATT8 | IF1 衰减8dB | ➡ |
| 78 | pin20 | 2ATT1 | IF2 衰减1dB | |
| 79 | pin21 | 2ATT2 | IF2 衰减2dB | |
| 80 | pin22 | 2ATT4 | IF2 衰减4dB | |
| 81 | pin23 | 2ATT8 | IF2 衰减8dB | |
| 82 | pin24 | 3ATT1 | IF3 衰减1dB | |
| 83 | pin25 | 3ATT2 | IF3 衰减2dB | |
| 84 | pin26 | 3ATT4 | IF3 衰减4dB | |
| 85 | pin27 | 3ATT8 | IF3 衰减8dB | |
| **备用** |
| 86-95 | pin28-37 | — | — | 保留 |

---

## KCKA, KCKB 编码

| KCKA | KCKB | 参考通道 |
|---|---|---|
| 1 | 1 | 通道 1 |
| 1 | 0 | 通道 2 |
| 0 | 1 | 通道 3 |
| 0 | 0 | 通道 4 |

---

## IF 宽窄带联动

KIFx1 和 KIFx2 应联动控制：

| KIFx1 (入) | KIFx2 (出) | 模式 |
|---|---|---|
| 0 (窄带)  | 1 (窄带) | 窄带 |
| 1 (宽带)  | 0 (宽带) | 宽带 |

## IF 衰减组合

| ATT1 | ATT2 | ATT4 | ATT8 | 总衰减 |
|---|---|---|---|---|
| 0 | 0 | 0 | 0 | 0dB |
| 1 | 0 | 0 | 0 | 1dB |
| 0 | 1 | 0 | 0 | 2dB |
| 1 | 1 | 0 | 0 | 3dB |
| 0 | 0 | 1 | 0 | 4dB |
| 0 | 0 | 0 | 1 | 8dB |
| 1 | 1 | 1 | 1 | 15dB |
