bbl21/STM32_ctrlmodule/hardware/bom/BOM_11542416A_Y1.xls

客户BOM清单 |  |  |  |  |  | 嘉立创用料信息
Comment | Description | Designator | Footprint | LibRef | Quantity | 匹配类型 | 匹配方式 | 匹配来源 | 顶层位号 | 顶层数 | 顶层贴装 | 底层位号 | 底层数 | 底层贴装 | 元件编号 | X-ray检查 | 贴装总数量 | 焊点总数量 | 焊点费小计 | 库类型 | 组装方式 | 元件名称 | 原厂型号 | 封装规格 | 最小起订数量 | 损耗数量 | 元器件来源 | 使用预订数量 | 工厂提供数量 | 工厂元件单价 | 工厂元件小计 | 换料费 | 收费原因
Type-C | USB-Type-C_16P | USB1 | TYPE-C_16P | USB-Type-C | 1 | 手动调整 | 手动替换 |  | USB1 | 1 | 已贴装 |  | 0 | 未贴装 | C165948 | 不需要 | 2 | 32 | 0.3200 | 扩展库 | 贴装 | Type-C 母 卧贴 | TYPE-C-31-M-12 | SMD | 2 | 0 | 商城现货 | 0 | 2 | 1.1290 | 2.2580 | 20.00
104 |  | C16,C17,C18,C19,C20,C21,C22,C23,C24,C25,C26,C27 | 0603 | 0603电容 | 12 | 系统识别 | 自动匹配 |  | C16, C17, C18, C19, C20, C21, C22, C23, C24, C25, C26, C27 | 12 | 已贴装 |  | 0 | 未贴装 | C14663 | 不需要 | 32 | 64 | 0.6400 | 基础库 | 贴装 | 100nF ±10% 50V | CC0603KRX7R9BB104 | 0603 | 0 | 0 | 商城现货 | 0 | 32 | 0.0156 | 0.4992 | 0.00
104，X7R |  | C1,C2,C3,C4 | 0603 | 0603电容 | 4 | 系统识别 | 自动匹配 |  | C1, C2, C3, C4 | 4 | 已贴装 |  | 0 | 未贴装 | C14663 | 不需要
330 |  | R7,R8 | 0603 | 0603电阻 | 2 | 手动调整 | 手动替换 |  | R7, R8 | 2 | 已贴装 |  | 0 | 未贴装 | C23140 | 不需要 | 4 | 8 | 0.0800 | 基础库 | 贴装 | 33Ω ±1% 100mW 厚膜电阻 | 0603WAF330JT5E | 0603 | 0 | 0 | 商城现货 | 0 | 4 | 0.0071 | 0.0284 | 0.00
LP5951MF-3.3 |  | U1,U2 | SOT23-5_2r90x1r60-H1r18-P0r95_G | LP5951MF-3.3 | 2 | 手动调整 | 手动替换 |  | U1, U2 | 2 | 已贴装 |  | 0 | 未贴装 | C80670 | 不需要 | 4 | 20 | 0.2000 | 扩展库 | 贴装 | 具有低 IQ 和使能功能的 250mA、低噪声、高 PSRR、超低压降稳压器 | LP5907MFX-3.3/NOPB | SOT-23-5 | 5 | 2 | 商城现货 | 0 | 6 | 0.6420 | 3.8520 | 20.00 | 5个以内不管购买几个，都收费3.8520元
STM32F103C6T7A |  | U3 | LQFP48-0r5-7x7-H1r6 | STM32F103C6T7A | 1 | 系统识别 | 自动匹配 |  | U3 | 1 | 已贴装 |  | 0 | 未贴装 | C222074 | 不需要 | 2 | 96 | 0.9600 | 扩展库 | 贴装 | 主流增强型ARM Cortex-M3 MCU，具有32 KB Flash、72 MHz CPU、电机控制、USB和CAN | STM32F103C6T7A | LQFP-48(7x7) | 0 | 0 | 商城现货 | 0 | 2 | 33.2900 | 66.5800 | 20.00
7V-8.000MAAE-T |  | X1 | RESO3225-4_3r20x2r50-H0r90-P2r10 | 7V-8.000MAAE-T | 1 | 手动调整 | 手动替换 |  | X1 | 1 | 已贴装 |  | 0 | 未贴装 | C9002 | 不需要 | 2 | 8 | 0.0800 | 基础库 | 贴装 | YSX321SL 12MHZ 4P 3225 20PF ±10PPM -40~85℃ (±20PPM) | X322512MSB4SI | SMD3225-4P | 0 | 0 | 商城现货 | 0 | 2 | 0.4340 | 0.8680 | 0.00
105，X7R |  | C5,C10,C11,C15 | 0603 | 0603电容 | 4 | 系统识别 | 自动匹配 |  | C5, C10, C11, C15 | 4 | 已贴装 |  | 0 | 未贴装 | C15849 | 不需要 | 8 | 16 | 0.1600 | 基础库 | 贴装 | 1uF ±10% 50V | CL10A105KB8NNNC | 0603 | 0 | 0 | 商城现货 | 0 | 8 | 0.0320 | 0.2560 | 0.00
512 |  | R5,R6 | 0603 | 0603电阻 | 2 | 系统识别 | 自动匹配 |  | R5, R6 | 2 | 已贴装 |  | 0 | 未贴装 | C23186 | 不需要 | 4 | 8 | 0.0800 | 基础库 | 贴装 | 5.1kΩ ±1% 100mW 厚膜电阻 | 0603WAF5101T5E | 0603 | 0 | 0 | 商城现货 | 0 | 4 | 0.0066 | 0.0264 | 0.00
152 |  | R3 | 0603 | 0603电阻 | 1 | 系统识别 | 自动匹配 |  | R3 | 1 | 已贴装 |  | 0 | 未贴装 | C22843 | 不需要 | 2 | 4 | 0.0400 | 基础库 | 贴装 | 1.5kΩ ±1% 100mW 厚膜电阻 | 0603WAF1501T5E | 0603 | 0 | 0 | 商城现货 | 0 | 2 | 0.0071 | 0.0142 | 0.00
SN74HC595PWR |  | N1,N2,N3,N4,N5,N6,N7,N8,N9,N10,N11,N12 | TSSOP16-0r65-5r0x4r4-H1r2 | SN74HC595PWR | 12 | 系统识别 | 自动匹配 |  | N1, N2, N3, N4, N5, N6, N7, N8, N9, N10, N11, N12 | 12 | 已贴装 |  | 0 | 未贴装 | C273642 | 不需要 | 24 | 384 | 3.8400 | 扩展库 | 贴装 | 三态输出 8位串行至串行或并行移位寄存器 | SN74HC595PWR | TSSOP-16 | 5 | 0 | 商城现货 | 0 | 24 | 0.8490 | 20.3760 | 20.00
16pF,NP0 |  | C13,C14 | 0603 | 0603电容 | 2 | 手动调整 | 手动替换 |  | C13, C14 | 2 | 已贴装 |  | 0 | 未贴装 | C1648 | 不需要 | 4 | 8 | 0.0800 | 基础库 | 贴装 | 20pF ±5% 50V | CL10C200JB8NNNC | 0603 | 0 | 0 | 商城现货 | 0 | 4 | 0.0322 | 0.1288 | 0.00
220 | Resistor_SMD | R2,R4 | RES_0402 | Resistor_SMD | 2 | 手动调整 | 手动替换 |  | R2, R4 | 2 | 已贴装 |  | 0 | 未贴装 | C25092 | 不需要 | 4 | 8 | 0.0800 | 基础库 | 贴装 | 22Ω ±1% 62.5mW 厚膜电阻 | 0402WGF220JTCE | 0402 | 0 | 0 | 商城现货 | 0 | 4 | 0.0039 | 0.0156 | 0.00
<-以下为不贴装的元件->
910 |  | R1 | 0603 | 0603电阻 | 1
