bbl21/STM32_ctrlmodule/(list of files, cad)

Other CAD files:
enclosure/上盖.STEP.SLDPRT
enclosure/底盒.STEP.SLDPRT
