bbl21/STM32_ctrlmodule/firmware/Core/Src/main.c

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
/* Includes ------------------------------------------------------------------*/
#include "main.h"
#include "usb_device.h"

/* USER CODE BEGIN Includes */
#include "usbd_cdc_if.h"
/* USER CODE END Includes */

SPI_HandleTypeDef hspi1;

/* USER CODE BEGIN PV */
// 用于 SPI 传输的缓冲区
uint16_t spi_buffer[6]; // 96位 = 6个16位数据
// 外部变量声明
extern uint8_t received_data[12];
extern uint8_t data_received;
/* USER CODE END PV */

void SystemClock_Config(void);
static void MX_GPIO_Init(void);
static void MX_SPI1_Init(void);
/* USER CODE BEGIN PFP */
// 字节位反转函数 - 将二进制位顺序颠倒
// 例如：输入 0x12 (二进制 00010010) → 输出 0x48 (二进制 01001000)
static uint8_t reverse_byte(uint8_t byte) {
    uint8_t result = 0;
    for (int i = 0; i < 8; i++) {
        // 从最低位开始，依次取每一位并放到结果的最高位
        result |= ((byte >> i) & 0x01) << (7 - i);
    }
    return result;
}

// 按四位反序函数
static uint8_t reverse_nibble(uint8_t byte) {
    return ((byte & 0x0F) << 4) | ((byte & 0xF0) >> 4);
}

// 调试函数：打印字节的二进制表示
static void print_byte_binary(uint8_t byte) {
    uint8_t debug_buf[20];
    int len = sprintf((char*)debug_buf, "0b");
    for (int i = 7; i >= 0; i--) {
        len += sprintf((char*)debug_buf + len, "%d", (byte >> i) & 0x01);
    }
    len += sprintf((char*)debug_buf + len, "\r\n");
    CDC_Transmit_FS(debug_buf, len);
}
/* USER CODE END PFP */

/**
  * @brief  The application entry point.
  * @retval int
  */
int main(void)
{

  /* MCU Configuration--------------------------------------------------------*/

  /* Reset of all peripherals, Initializes the Flash interface and the Systick. */
  HAL_Init();

  /* Configure the system clock */
  SystemClock_Config();

  /* Initialize all configured peripherals */
  MX_GPIO_Init();
  MX_SPI1_Init();
  MX_USB_DEVICE_Init();
  /* USER CODE BEGIN 2 */
  // 使能 595 输出（PB3 低电平）
  HAL_GPIO_WritePin(GPIOB, GPIO_PIN_3, GPIO_PIN_RESET);
  // 初始化 STCP 为低电平
  HAL_GPIO_WritePin(GPIOB, GPIO_PIN_5, GPIO_PIN_RESET);
  /* USER CODE END 2 */

  /* Infinite loop */
  /* USER CODE BEGIN WHILE */
  while (1)
  {
    /* USER CODE END WHILE */

    /* USER CODE BEGIN 3 */
    // 检查是否有数据接收到
    if (data_received)
    {
      // 发送接收到的数据以供调试
      uint8_t debug_buf[100];
      int len = sprintf((char*)debug_buf, "Received: ");
      for (int i = 0; i < 12; i++) {
        len += sprintf((char*)debug_buf + len, "%02X ", received_data[i]);
      }
      len += sprintf((char*)debug_buf + len, "\r\n");
      CDC_Transmit_FS(debug_buf, len);
      
      // 准备 SPI 传输数据
      
      if(12 == 12) {
          // 将12字节(96位)完全位反转后输出到6个16位字(MSB first)
          for (int i = 0; i < 6; i++) {
              spi_buffer[i] = 0;
          }
          for (int i = 0; i < 12; i++) {
              for (int b = 0; b < 8; b++) {
                  if (received_data[i] & (0x80 >> b)) {
                      int pos = 95 - (i * 8 + b);
                      spi_buffer[pos / 16] |= (0x8000 >> (pos % 16));
                  }
              }
          }
          
          // 发送 SPI 要发送的数据以供调试
          len = sprintf((char*)debug_buf, "SPI Send: ");
          for (int i = 0; i < 6; i++) {
            len += sprintf((char*)debug_buf + len, "%04X ", spi_buffer[i]);
          }
          len += sprintf((char*)debug_buf + len, "\r\n");
          CDC_Transmit_FS(debug_buf, len);
          
          // 通过SPI依次发送6个16位数据
          HAL_SPI_Transmit(&hspi1, (uint8_t*)spi_buffer, 6, 100);  // 传输6个16位数据项
          HAL_GPIO_WritePin(GPIOB, GPIO_PIN_5, GPIO_PIN_SET); /* PB5拉高 */
          HAL_Delay(1); /* 延时保持脉冲宽度 */
          HAL_GPIO_WritePin(GPIOB, GPIO_PIN_5, GPIO_PIN_RESET); /* PB5拉低 */
          
          // 发送操作完成信息
          CDC_Transmit_FS((uint8_t*)"Operation completed\r\n", 20);
      } 
      // 数据处理后状态输出
      data_received = 0;
    }
    
    HAL_Delay(1); // 避免死循环占满 CPU
  }
  /* USER CODE END 3 */
}

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
