bbl21/STM32_ctrlmodule/firmware/ctrl_module_v4.ioc

Mcu.UserName=STM32F103C8Tx
PA11.Signal=USB_DM
PA12.Signal=USB_DP
PA13.Signal=SYS_JTMS-SWDIO
PA14.Signal=SYS_JTCK-SWCLK
PA5.Signal=SPI1_SCK
PA7.Signal=SPI1_MOSI
PB3.Signal=GPIO_Output
PB5.Signal=GPIO_Output
PD0-OSC_IN.Signal=RCC_OSC_IN
PD1-OSC_OUT.Signal=RCC_OSC_OUT
