bbl21/STM32_ctrlmodule/(commit log)

2026-06-08 initial: 射频前端控制模块 V04
    firmware/: STM32F103 固件 (USB CDC + SPI → 74HC595)
    software/: Qt6 上位机控制软件
    hardware/: Altium 电路设计、Gerber、BOM
    enclosure/: 射频盒体外壳 3D 模型
    docs/: 项目文档、位映射定义、原理图
    [BOM_11542416A_Y1.xls, BOM_Board1_PCB1_2026-04-01.xlsx, BOM_PASTER_11542416A_Y1.xls, DXF_PCB1_2026-04-07_AutoCAD2007.dxf, PCB1.PcbDoc, PickAndPlace_PCB1_2026_04_01.xlsx, Sheet1.SchDoc, ctrl_module.xlsx]
2026-06-09 整理：移除图片引用/更新外壳模型/调整硬件目录结构
    - docs: 移除图片引用，修正固件算法描述（nibble swap→全位序反转）
    - enclosure: 替换为 上盖+底盒 SLDPRT 文件
    - hardware: 调整目录结构，Gerber/Altium/PCB3D 移出仓库
    - docs: 更新目录索引、开发环境信息
    [BOM_Board1_PCB1_2026-04-01.xlsx, DXF_PCB1_2026-04-07_AutoCAD2007.dxf, PCB1.PcbDoc, Sheet1.SchDoc, ctrl_module.xlsx, 上盖.STEP.SLDPRT, 底盒.STEP.SLDPRT]
